ningpj/myVoronMods/README.md

# Voron_Mods

Various modifications created for my Voron printers.
