ningpj/myVoronMods/v0.2 Crossbow Cutter Depressor/README.md

# v0.2 Crossbow Cutter Depressor

## Description

CNC Crossbow toolhead filament cutters are awesome. For a bit of fun, I fitted one to my V0.2 so EMU can act as a convenient filament changer rather than a full multi‑material setup.

I originally planned a servo‑actuated arm, but since the bed magnet already lets the build plate lift when printing edge‑to‑edge parts, losing a few millimetres of front print area isn’t the end of the world IMO.

I’ve created and evaluated several mounting options that bolt to the front‑left 1515 extrusion. This evolved to MK II mid‑body and MK III to further minimise lost build space. Currently using MK III. 

With MK I I lost roughly 7 mm × 25 mm of usable area and masked this in my slicer using `0x0, 0x25, 7x25, 7x0, 0x0`.
MK II and MK III you only sacrifice 7mm x 14mm of space - `0x0, 0x14, 7x14, 7x0, 0x0`

Happy‑Hare cutting settings for MK II & MK III:
```
variable_cutting_axis           : "y"
variable_pin_loc_xy             : 4.7, 2
variable_pin_park_dist          : -2
variable_pin_loc_compressed_xy  : 4.7, 16.5
```

> [!NOTE]
> X needs to be at least 4.7 mm so the Crossbow arm doesn’t hit the 1515 extrusion during the cut maneuver and causing skipped steps.

V0 2 Crossbow Depressor MK I
V0 2 Crossbow Depressor MK II
V0 2 Crossbow Depressor MK III

## Change Log

* Published
