ningpj/myVoronMods/Mellow Fly-SHT36 v2 Orbiter 2.0 CAN Mount/README.md

# Prototype v2.4 Mellow Fly-SHT36 v2.0 Orbiter 2.0 CAN Board mount and umbilical strain relief.

## Description

*** Note *** this needs to be reworked for use with Voron 2.4 as the CNA umbilical gets caught in left rear Z idler :-(

Mellow Fly-SHT36 v2.0 Orbiter 2.0 CAN board mount and umbilical strain relief. 90-degree with back turn.

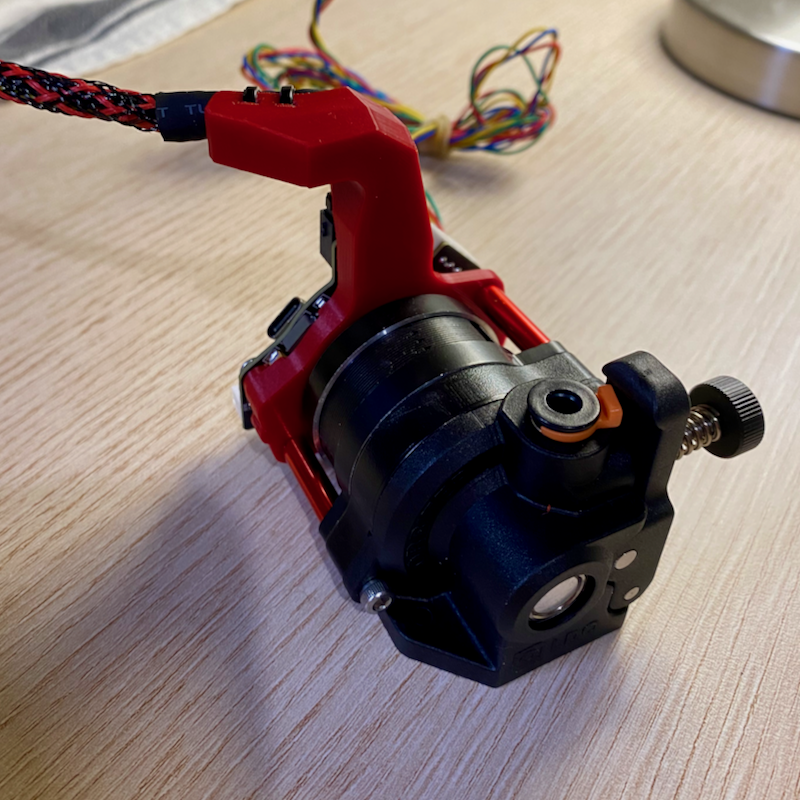
[picture p11: Mellow Fly-SHT36 v2 Orbiter 2.0 CAN Mount/images/Mellow_Fly-SHT36_v2_Orbiter_2_Mount_Front.png]

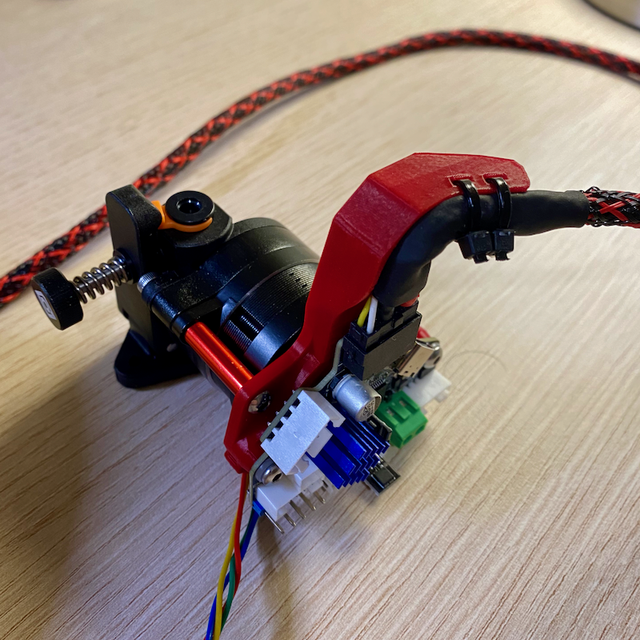
[picture p12: Mellow Fly-SHT36 v2 Orbiter 2.0 CAN Mount/images/Mellow_Fly-SHT36_v2_Orbiter_2_Mount_Back.png]


## Change Log

* Published
