ningpj/myVoronMods/v0.2 Dragon Burner Orbiter 2.0 Umbilical Toolheat Mount/README.md

# v0.2 Dragon Burner Orbitor 2.0 Umbilical Toolhead Mount

## Description

Remix of the VoronDesign v0.2 umbilical toolhead mount for Orbiter 2.0 and Dragon Burner hotend. The mount is offset slightly from stock and screws to the back of the x-carriage and standoffs attached to the Orbiter motor mount m3's.
Umbilical board and zip tie points relocated given offset layout and v0.2 x-carriage and Orbiter mounts.

Umbilical circuit board mounts using m3 into plastic (self-tap) on one side and through hole m3 to threaded standoff on other side.

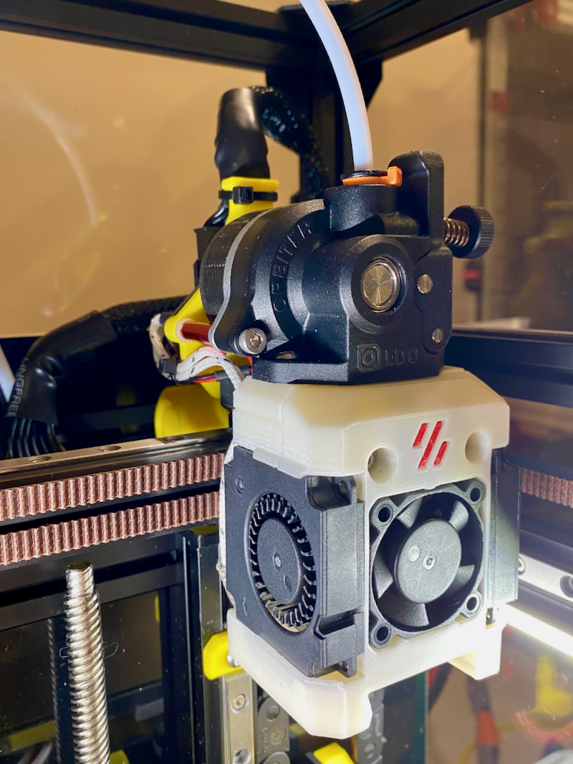
[picture p13: v0.2 Dragon Burner Orbiter 2.0 Umbilical Toolheat Mount/images/Orbiter_2.0_Umbilical_Dragon_Burner_Mount-front.png]
 <br><br>
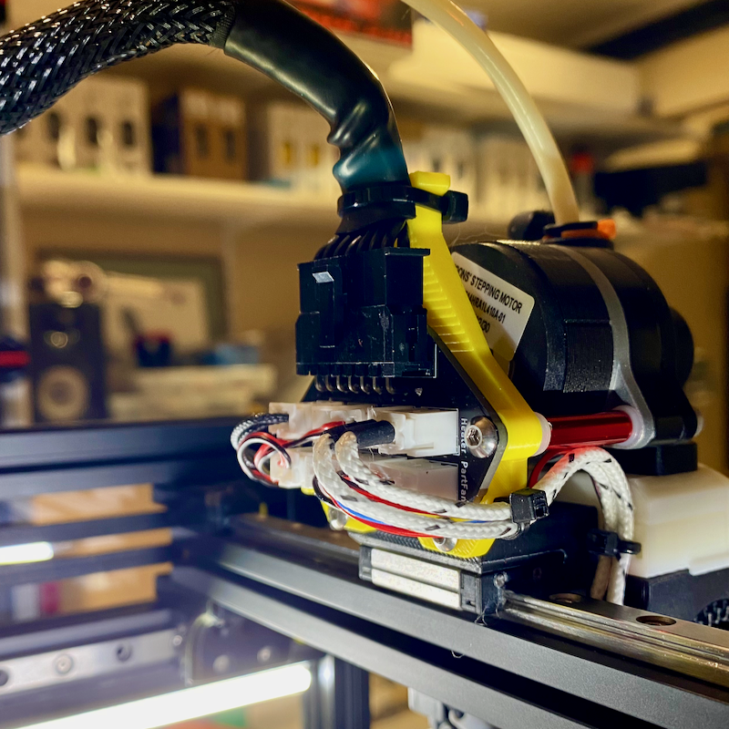
[picture p14: v0.2 Dragon Burner Orbiter 2.0 Umbilical Toolheat Mount/images/Orbiter_2.0_Umbilical_Dragon_Burner_Mount-back.png]


## Change Log

* Published
