ningpj/myVoronMods/v0.2 COB LED Press Fit Mount/README.md

# v0.2r1 COB LED Press Fit Mount

## Description

Quick remix (hack) using Tinkercad of @RichardM's excellent https://www.printables.com/model/172405-clip-in-led-mounts-for-voron-0-1515-extrusion 1515 LED mounts to change the profile to allow me to attach self-adhesive 24v COB LED light strips (natural white 4000k, 480 LEDS/metre).
I use COB lights for all my printers as they are simple, get the job done, PWM well, and have built in diffusers so don’t take up much space.  I PWM cap them at 60% power and run them at 40% when printing which is plenty bright enough.  In hindsight, 384 LEDS/metre would provide ample illumination for printer use. I have two short strips mounted under each Y rail.  Since I have no interest in servo mounted options at this stage for the v0.2 this keeps them well out of the way and means I dont have to faff around wiring up 5v nozzle sequin LEDs on the hotend as they throw sufficient light to see whats going on.  

@RicharM 1515 mounts are really elegant and are the best press fit channel mounts I have seen.  They use sets of 3, alternating interlocking fingers that snap into the 1515 channels and hold on super tight - all credit for the excellent design to https://www.printables.com/@RichardM.
Richard is also a member of the Voron Discord @whistlinric 

They do need to be printed vertically so will need to print these on a bigger printer than the v0.2.

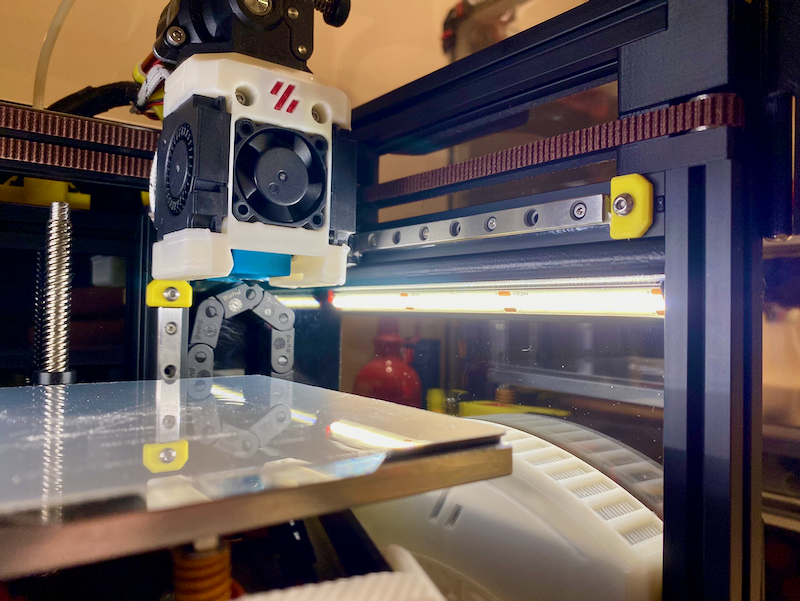
[picture p16: v0.2 COB LED Press Fit Mount/images/1515_COB_LED_Mount.png]


## Change Log

* Published
