ningpj/myVoronMods/v0.2 Stealth Rear Skirt with 2x Keystones/README.md

# v0.2 Stealth Skirts Rear Panel Keystones

## Description

Remixed and modified rear Stealth Skirts panel for v0.2 with dual keystone ports for RJ45 joiners for RPi Ethernet and Input Shaper ports.
Note this is for the standard v0.2 Stealth Skirts and "may" need updated when Maveric gets around to raisng the feet and incorporating v0.2r1 
integrated runout detector. 

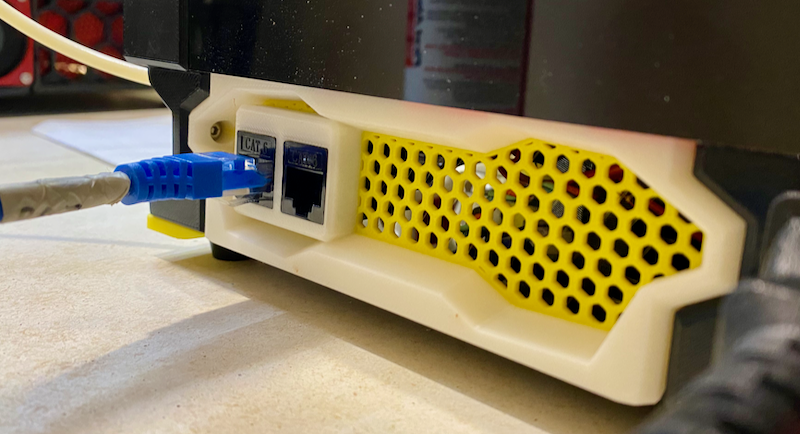
[picture p22: v0.2 Stealth Rear Skirt with 2x Keystones/images/Rear_Stealth_Skirt_with_2x_Keystones_1.png]

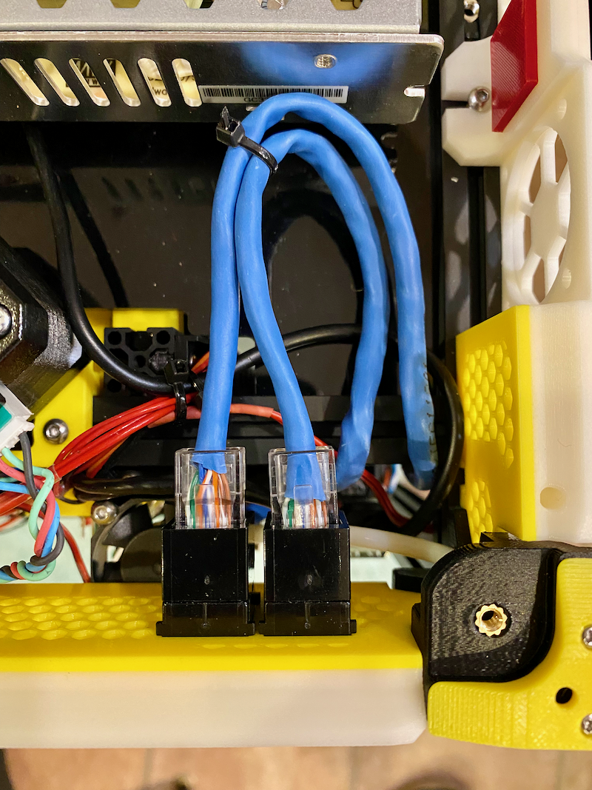
[picture p23: v0.2 Stealth Rear Skirt with 2x Keystones/images/Rear_Stealth_Skirt_with_2x_Keystones_2.png]

<br><br>
Unfortunately this symetrical orientation didnt allow enought room to clear the Z Stepper with RJ45 keystone joiner and plug/cable so needed to
change the layout :-(   
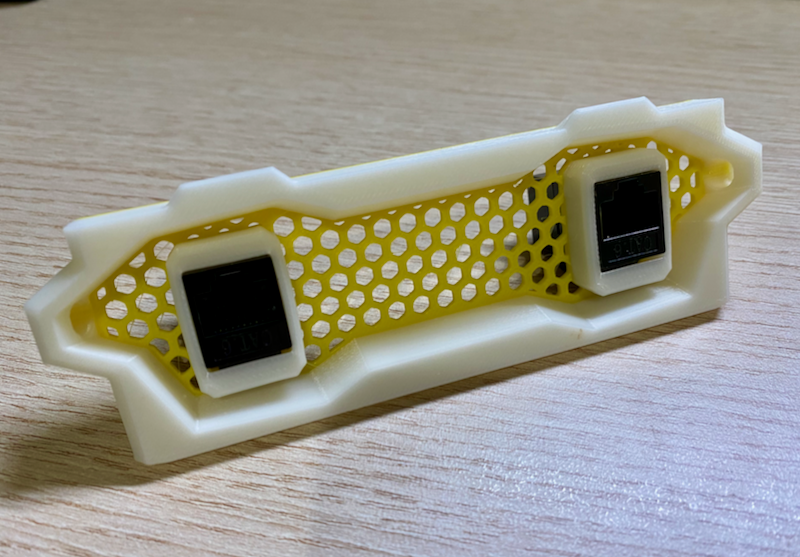
[picture p24: v0.2 Stealth Rear Skirt with 2x Keystones/images/Rear_Stealth_Skirt_with_2x_Keystones.png]


## Change Log

* Published
