ningpj/myVoronMods/Blobifier Modifications/images/v2.4_Extended_Static_Wipe_Rest.png

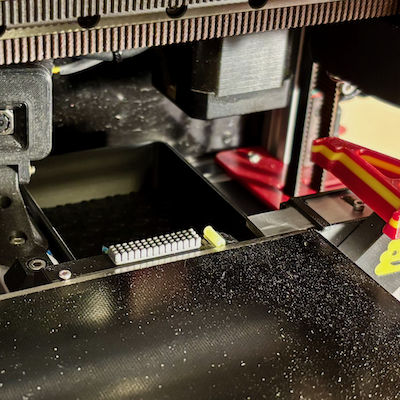
Blobifier Modifications/images/v2.4_Extended_Static_Wipe_Rest.png
