ningpj/myVoronMods/Blobifier Modifications/images/v2.4_Gantry_Wipe_Rest_MK_I.png

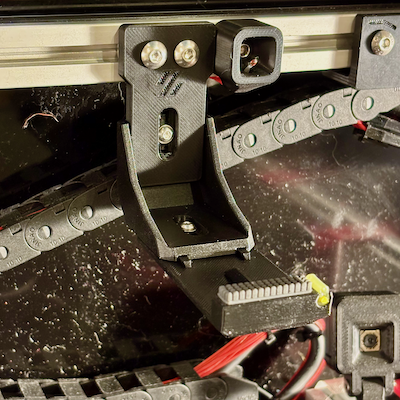
Blobifier Modifications/images/v2.4_Gantry_Wipe_Rest_MK_I.png
