ningpj/myVoronMods/Blobifier Modifications/images/v2.4_Gantry_Wipe_Rest_MK_I_Parked.png

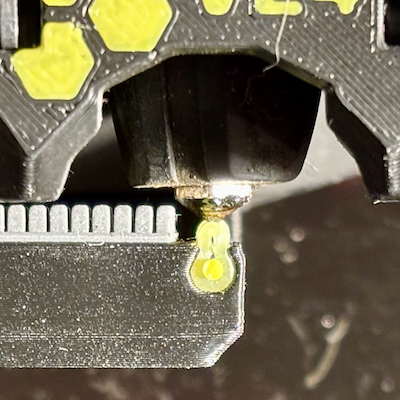
Blobifier Modifications/images/v2.4_Gantry_Wipe_Rest_MK_I_Parked.png
