ningpj/myVoronMods/Blobifier Modifications/images/Voron_v2.4_300mm_Blobifier_Dimensions.png

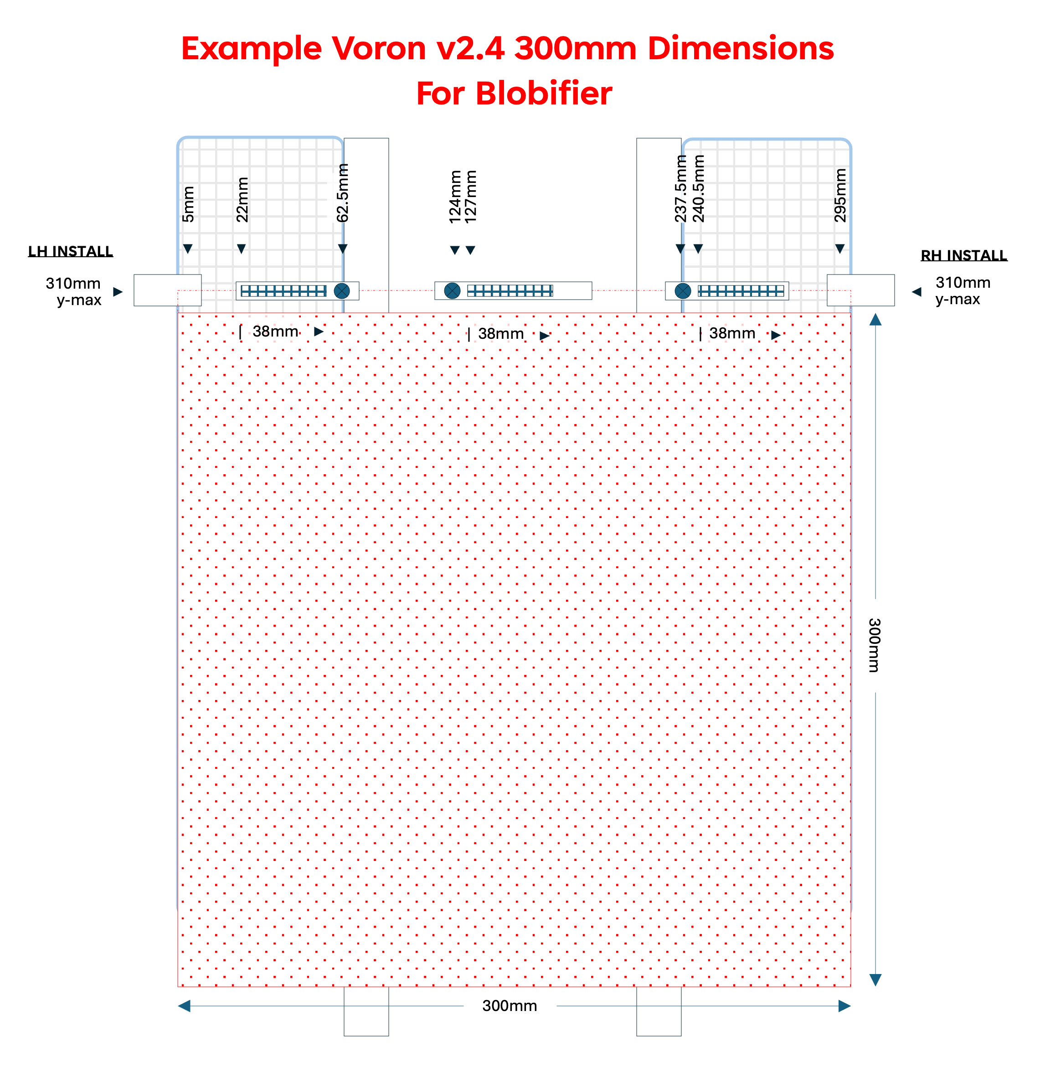
Blobifier Modifications/images/Voron_v2.4_300mm_Blobifier_Dimensions.png
