ningpj/myVoronMods/Blobifier Modifications/Adjustable Gantry Wiper - Mount.step

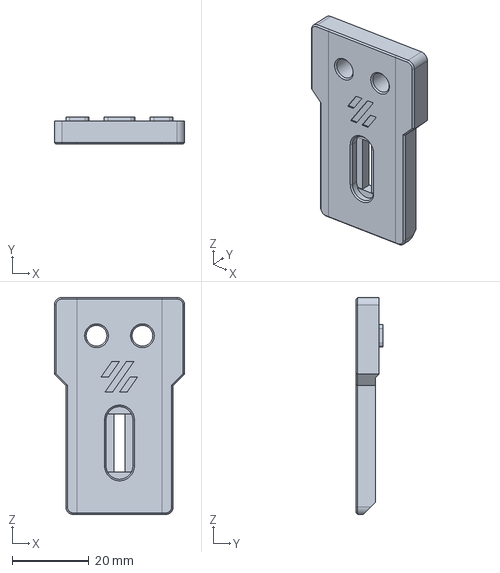
[picture p29: CAD file, 2025-07-21]
Blobifier Modifications/Adjustable Gantry Wiper - Mount.step
34.1 x 6.98 x 56.7 mm
