ningpj/myVoronMods/ERCF v2 Community Universal Servo Horn/Universal Servo Horn - M3 Hex.stl

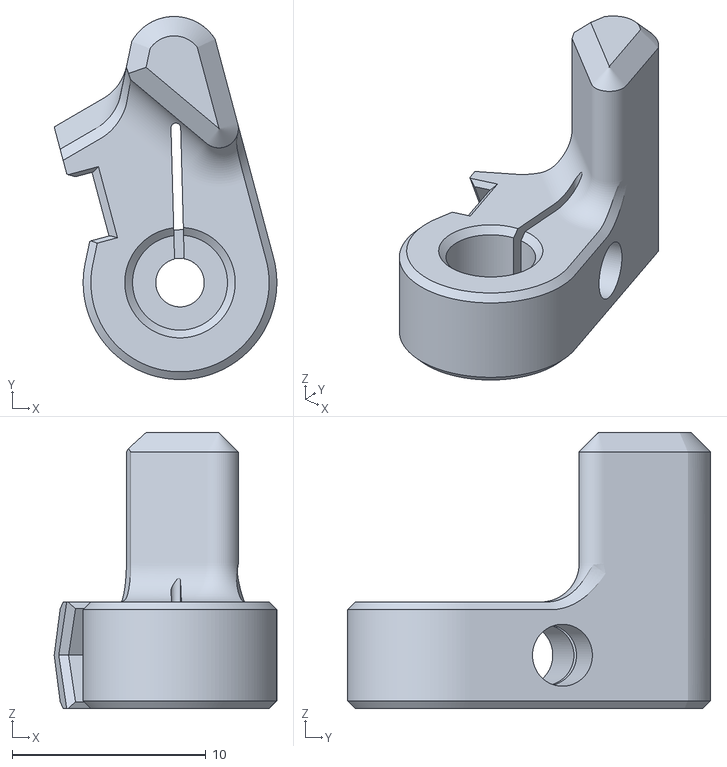
[picture p30: CAD file, 2024-08-23]
ERCF v2 Community Universal Servo Horn/Universal Servo Horn - M3 Hex.stl
11.5 x 18.7 x 14.2
