ningpj/myVoronMods/Mellow Fly-SHT36 v2 Orbiter 2.0 CAN Mount/Mellow BTT FLY-SHT-36 v2 Orbiter 2.0 CAN Mount v51.step

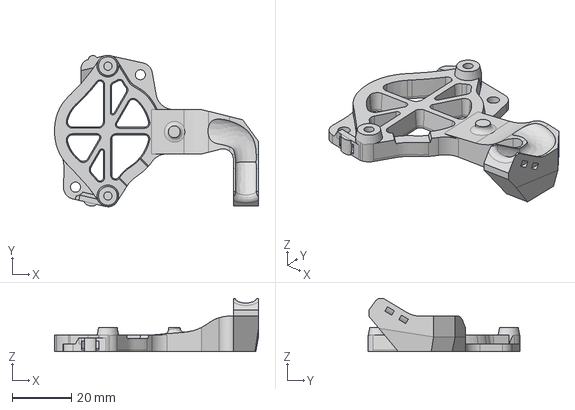
[picture p31: CAD file, 2023-07-01]
Mellow Fly-SHT36 v2 Orbiter 2.0 CAN Mount/Mellow BTT FLY-SHT-36 v2 Orbiter 2.0 CAN Mount v51.step
68.9 x 51.2 x 18.0 mm
