ningpj/myVoronMods/v0.2 ADXL Nozzle Mount/ADXL Nozzle Mount m3.stl

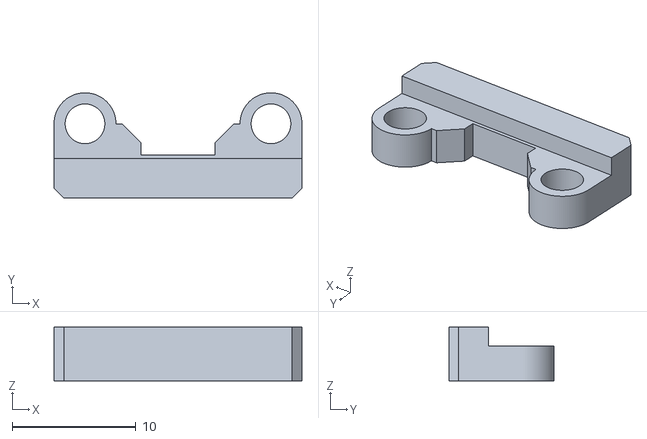
[picture p32: CAD file, 2023-06-18]
v0.2 ADXL Nozzle Mount/ADXL Nozzle Mount m3.stl
20.0 x 8.50 x 4.32
