ningpj/myVoronMods/v0.2 Aliexpress Clone Waggo 221-412 Kirigami mount/Aliexpress Clone Wago 221-412 3x2 Kirigami mount v4.step

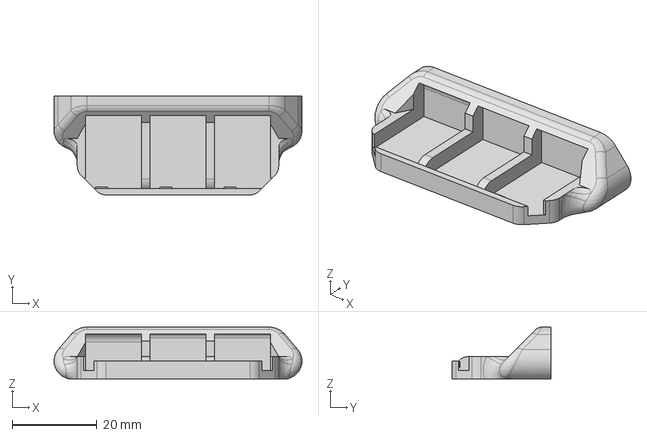
[picture p33: CAD file, 2023-06-18]
v0.2 Aliexpress Clone Waggo 221-412 Kirigami mount/Aliexpress Clone Wago 221-412 3x2 Kirigami mount v4.step
58.4 x 23.2 x 12.2 mm
