ningpj/myVoronMods/v0.2 COB LED Press Fit Mount/COB Light Remix - Funky Hango-Wluff.stl

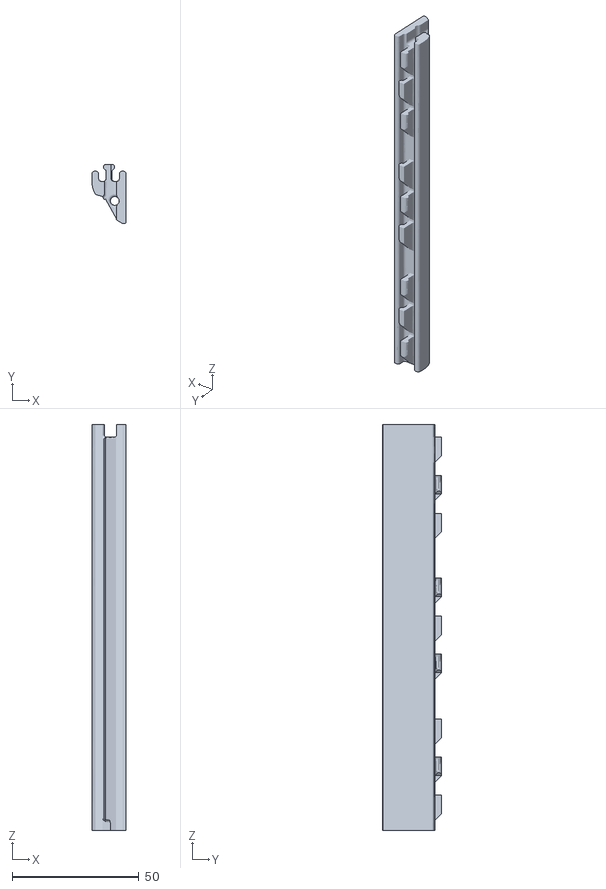
[picture p34: CAD file, 2023-06-18]
v0.2 COB LED Press Fit Mount/COB Light Remix - Funky Hango-Wluff.stl
13.5 x 23.4 x 160.0
