ningpj/myVoronMods/v0.2 Crossbow Cutter Depressor/V0.2 Crossbow Depressor MK III v4.step

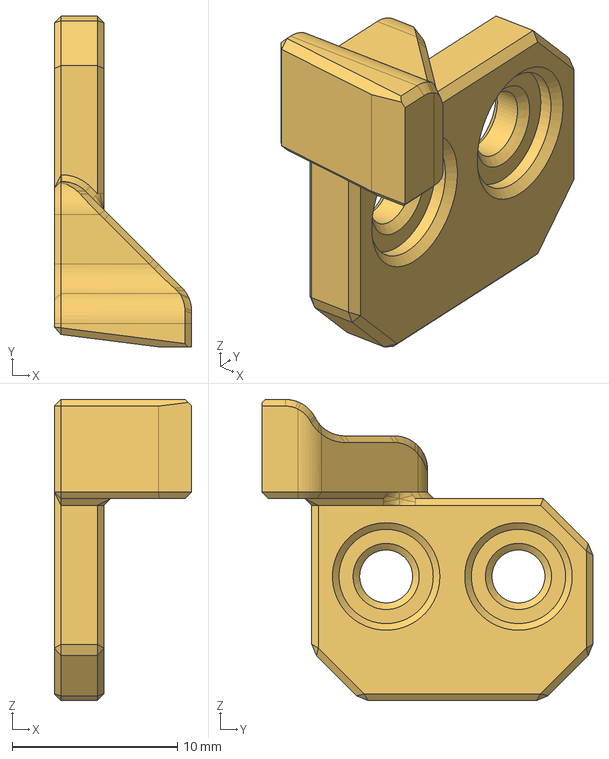
[picture p35: CAD file, 2026-05-24]
v0.2 Crossbow Cutter Depressor/V0.2 Crossbow Depressor MK III v4.step
8.30 x 20.0 x 18.2 mm
