ningpj/myVoronMods/v0.2 Dragon Burner Orbiter 2.0 Umbilical Toolheat Mount/v0.2 Dragon Burner Orbiter 2.0 Umbilical Toolhead Mount.stl

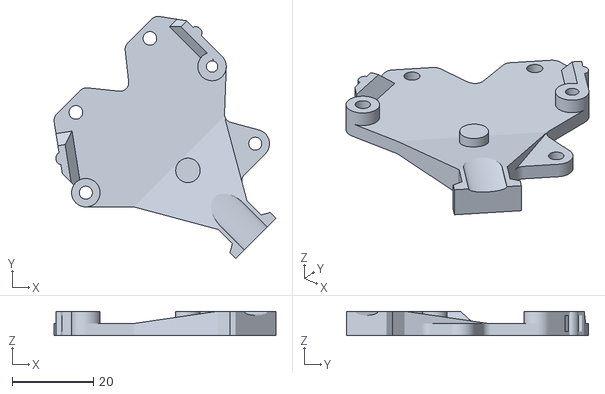
[picture p36: CAD file, 2023-06-20]
v0.2 Dragon Burner Orbiter 2.0 Umbilical Toolheat Mount/v0.2 Dragon Burner Orbiter 2.0 Umbilical Toolhead Mount.stl
54.5 x 59.5 x 6.00
