ningpj/myVoronMods/v0.2 Formbot Deck Chain Cap Cover/v0.2 Formbot Deck Chain Gap Cover.stl

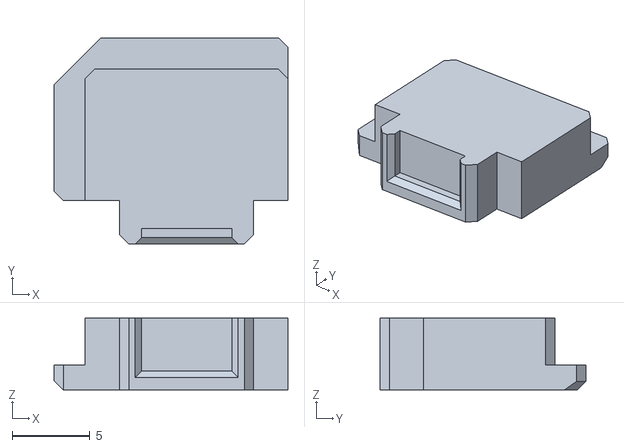
[picture p37: CAD file, 2023-06-20]
v0.2 Formbot Deck Chain Cap Cover/v0.2 Formbot Deck Chain Gap Cover.stl
15.0 x 13.2 x 4.60
