ningpj/myVoronMods/v0.2 Formbot Umbilical Panel Thermistor Shroud/V0.2 Formbot Umbilical Panel Thermistor Shroud v7.step

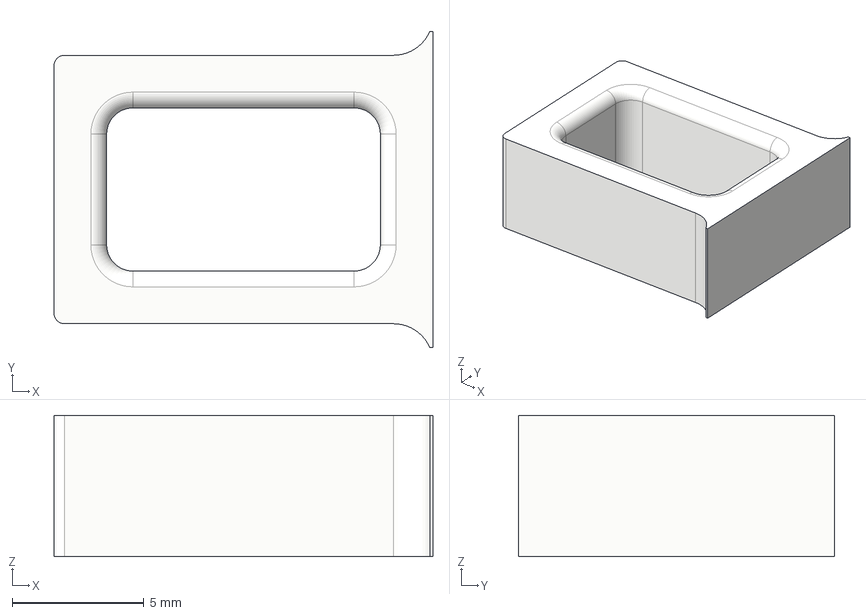
[picture p38: CAD file, 2023-06-18]
v0.2 Formbot Umbilical Panel Thermistor Shroud/V0.2 Formbot Umbilical Panel Thermistor Shroud v7.step
14.4 x 12.0 x 5.36 mm
