ningpj/myVoronMods/v0.2 Stealth Handle Top Hat, Side Panel Gap Fillers/Left Gap Filler.stl

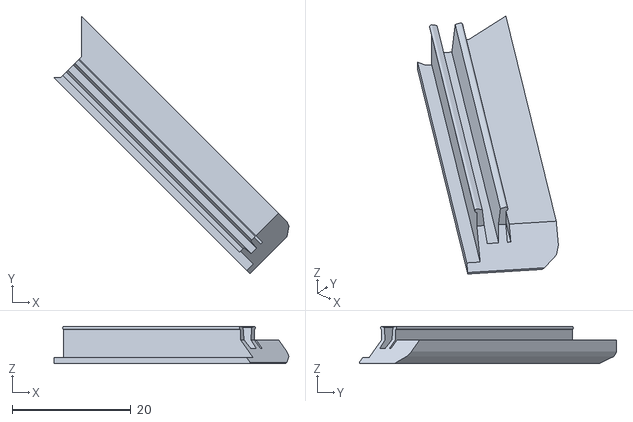
[picture p39: CAD file, 2023-06-18]
v0.2 Stealth Handle Top Hat, Side Panel Gap Fillers/Left Gap Filler.stl
39.6 x 43.4 x 6.25
