ningpj/myVoronMods/v0.2 Stealth Rear Skirt with 2x Keystones/V0.2 Rear Stealth Skirt with 2x Keystones v15.step

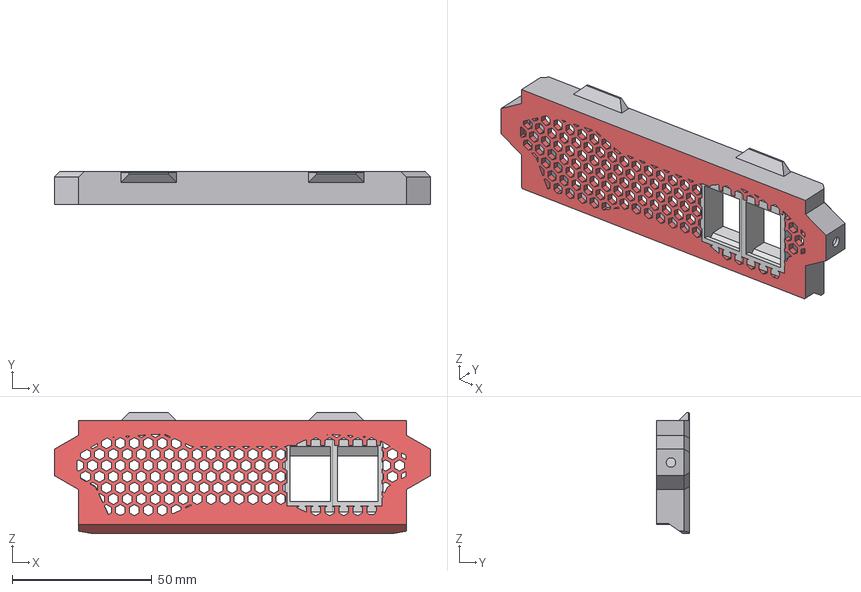
[picture p40: CAD file, 2023-06-25]
v0.2 Stealth Rear Skirt with 2x Keystones/V0.2 Rear Stealth Skirt with 2x Keystones v15.step
134.7 x 12.0 x 43.5 mm
Rear Skirt:1
Keystone
Keystone (1)
