ningpj/myVoronMods/v0.2 Sturdy PTFE & Umbilical Strain Relief/v0.2 Sturdy PTFE & Umbilical Strain Relief v10.step

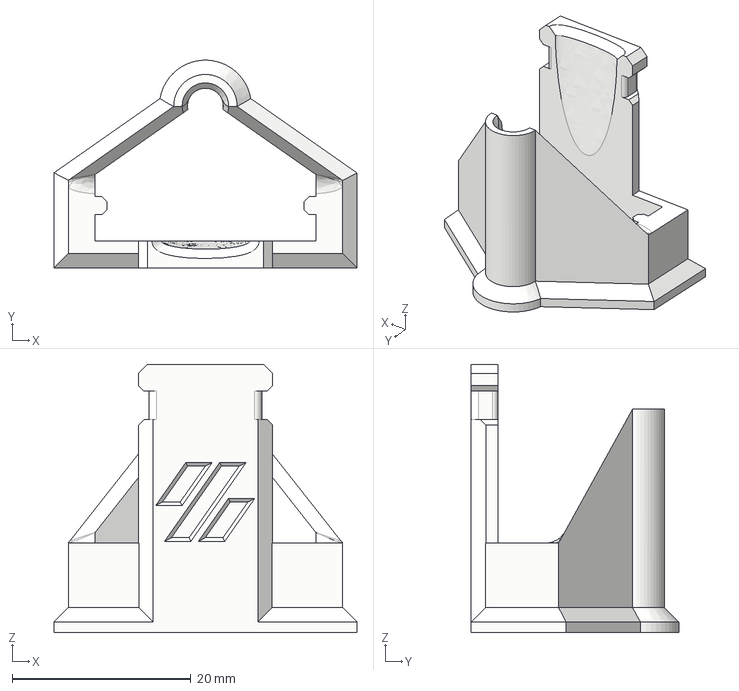
[picture p41: CAD file, 2023-06-18]
v0.2 Sturdy PTFE & Umbilical Strain Relief/v0.2 Sturdy PTFE & Umbilical Strain Relief v10.step
33.9 x 23.2 x 30.0 mm
