ningpj/myVoronMods/Blobifier Modifications/Adjustable Gantry Wiper - Bracket.step

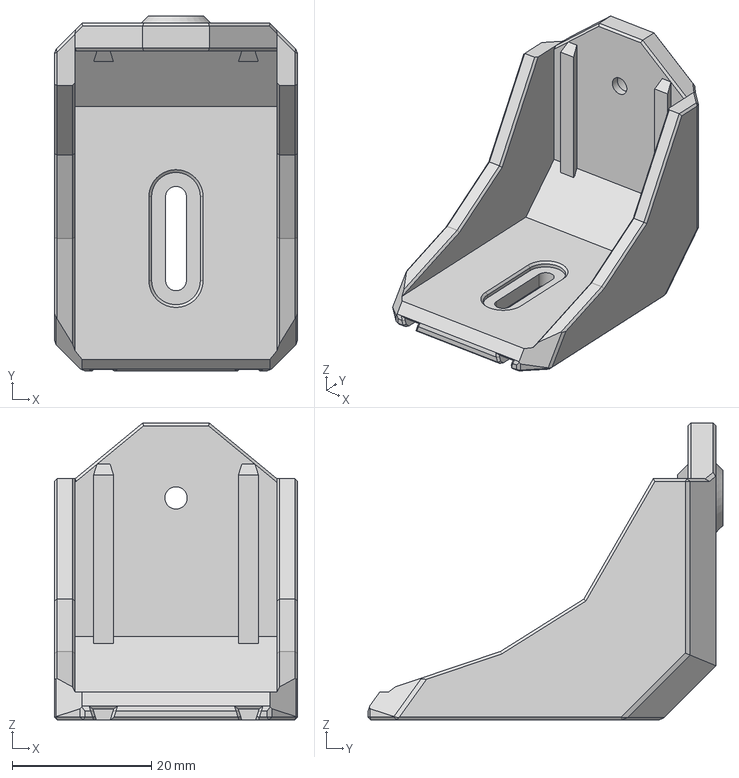
[picture p42: CAD file, 2025-07-21]
Blobifier Modifications/Adjustable Gantry Wiper - Bracket.step
35.0 x 51.0 x 42.7 mm
