ningpj/myVoronMods/ERCF v2 Community Universal Servo Horn/Universal Servo Horn - M3 Hex v14.step

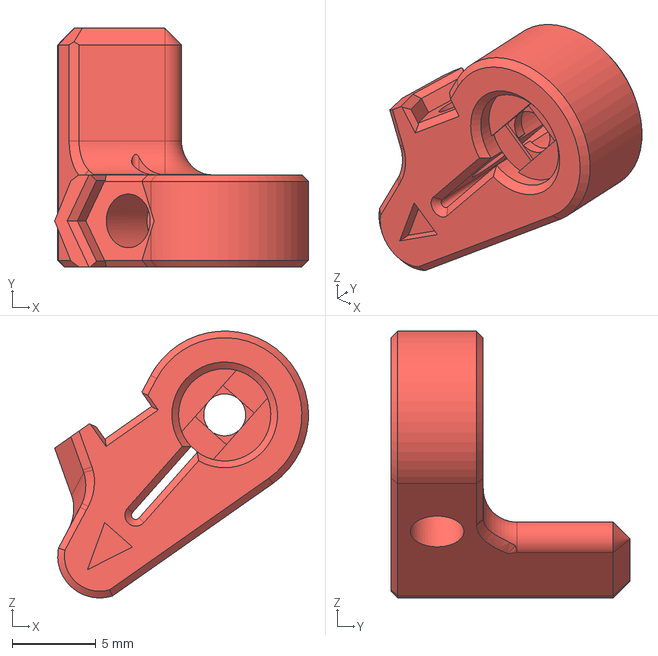
[picture p43: CAD file, 2024-08-23]
ERCF v2 Community Universal Servo Horn/Universal Servo Horn - M3 Hex v14.step
15.1 x 14.2 x 15.9 mm
