ningpj/myVoronMods/v0.2 Crossbow Cutter Depressor/V0.2 Crossbow Depressor MK II v2.step

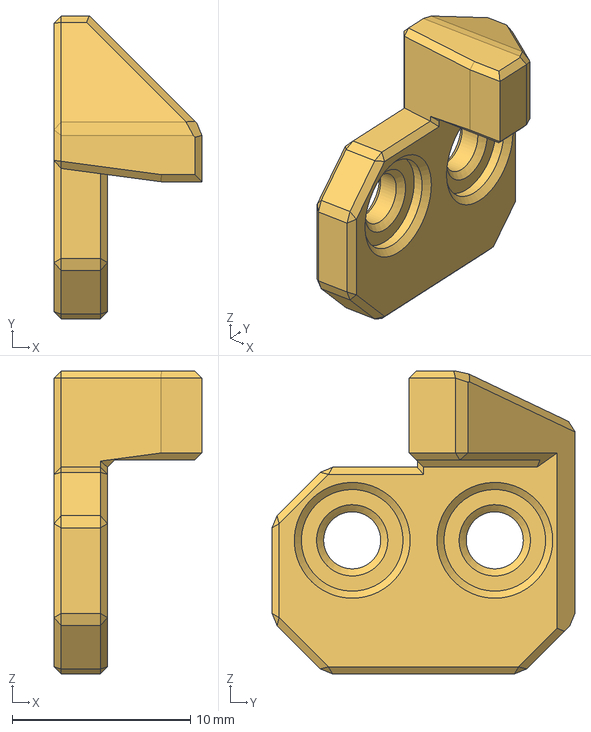
[picture p44: CAD file, 2026-05-22]
v0.2 Crossbow Cutter Depressor/V0.2 Crossbow Depressor MK II v2.step
8.30 x 17.0 x 17.0 mm
