ningpj/myVoronMods/v0.2 Dragon Burner Orbiter 2.0 Umbilical Toolheat Mount/v0.2 Dragon_Burner_Orbiter2.0 Umbilical Toolhead Mount v28.step

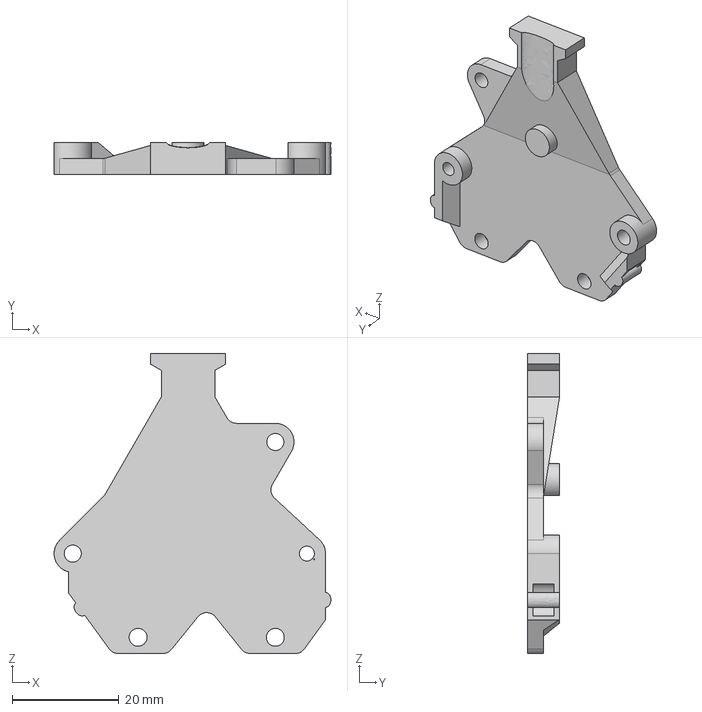
[picture p45: CAD file, 2023-06-18]
v0.2 Dragon Burner Orbiter 2.0 Umbilical Toolheat Mount/v0.2 Dragon_Burner_Orbiter2.0 Umbilical Toolhead Mount v28.step
51.8 x 6.00 x 56.2 mm
