ningpj/myVoronMods/v0.2 Formbot Umbilical Panel Thermistor Shroud/V0.2 4-way JST Fan Bus v7.step

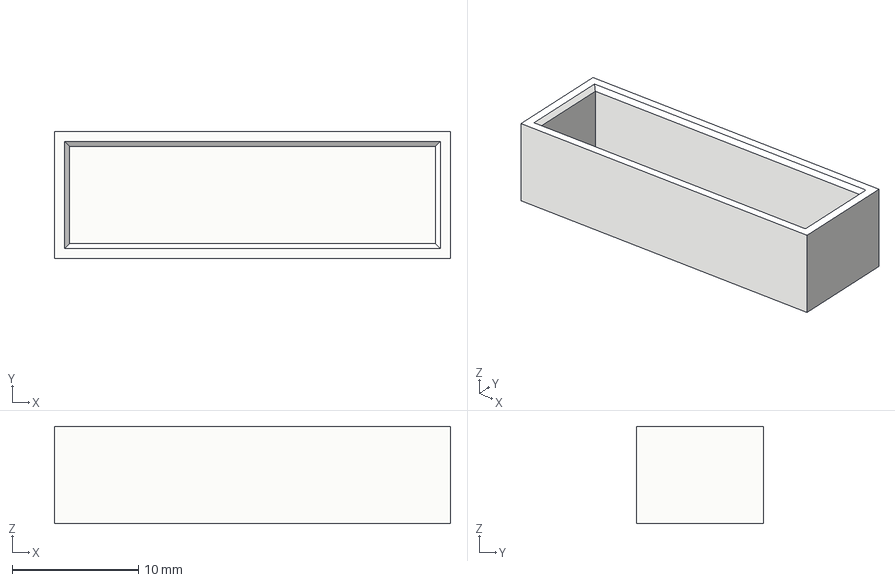
[picture p46: CAD file, 2023-06-18]
v0.2 Formbot Umbilical Panel Thermistor Shroud/V0.2 4-way JST Fan Bus v7.step
31.4 x 10.1 x 7.70 mm
