ningpj/myVoronMods/Blobifier Modifications/Adjustable Gantry Wiper - Wiper and rest.step

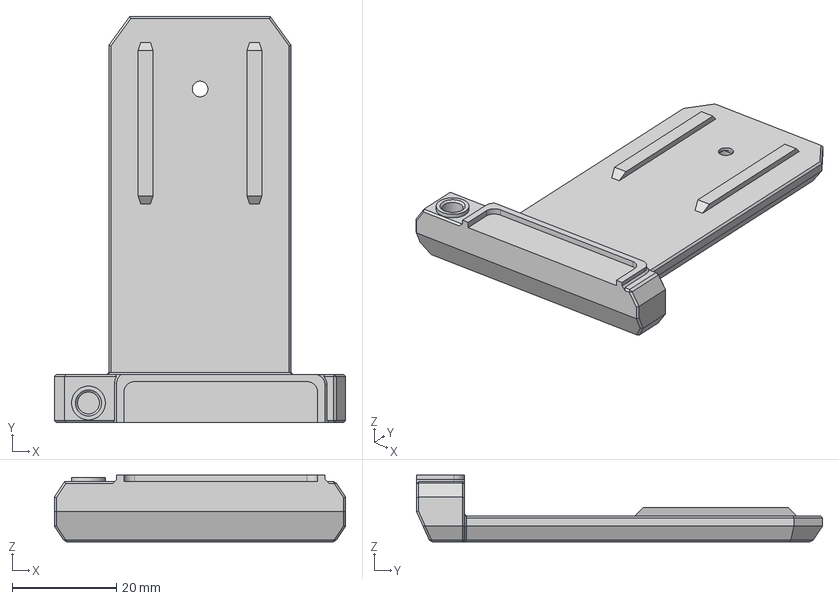
[picture p47: CAD file, 2025-07-21]
Blobifier Modifications/Adjustable Gantry Wiper - Wiper and rest.step
56.0 x 78.0 x 12.8 mm
