ningpj/myVoronMods/v0.2 Crossbow Cutter Depressor/V0.2 Crossbow Depressor MK I v5.step

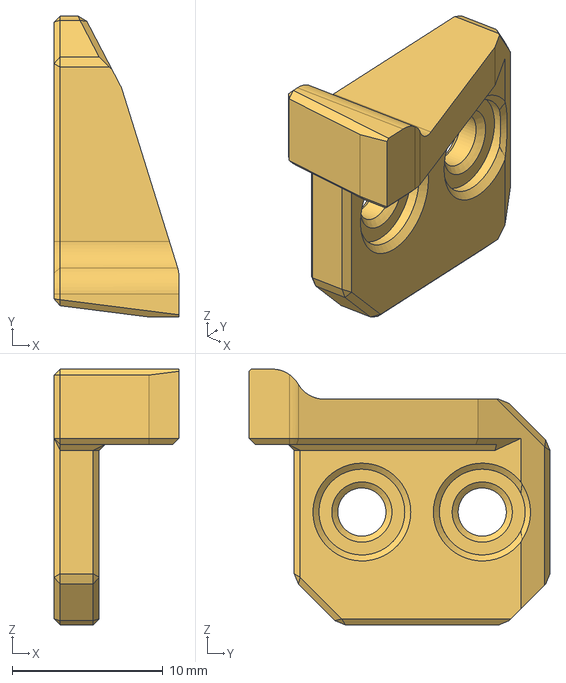
[picture p48: CAD file, 2026-05-22]
v0.2 Crossbow Cutter Depressor/V0.2 Crossbow Depressor MK I v5.step
8.30 x 20.0 x 17.0 mm
