ningpj/myVoronMods/v0.2 Stealth Handle Top Hat, Side Panel Gap Fillers/v2.0 Stealth Handle top hat, side panel gap fillers v15.step

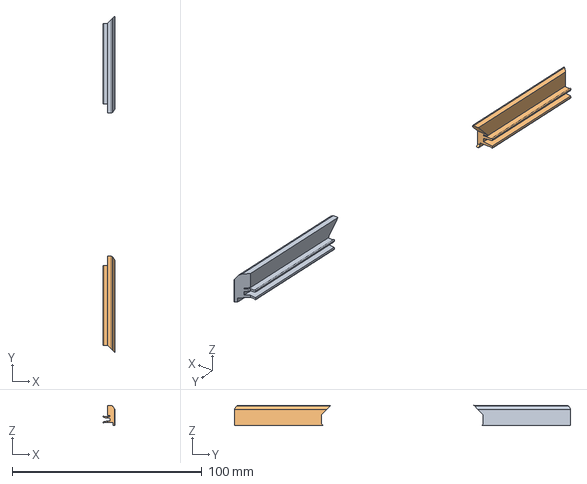
[picture p49: CAD file, 2023-06-18]
v0.2 Stealth Handle Top Hat, Side Panel Gap Fillers/v2.0 Stealth Handle top hat, side panel gap fillers v15.step
6.25 x 177.0 x 10.6 mm
