ningpj/myVoronMods/Blobifier Modifications/Adjustable Gantry & Static wipe & rests v32 - Mount.stl

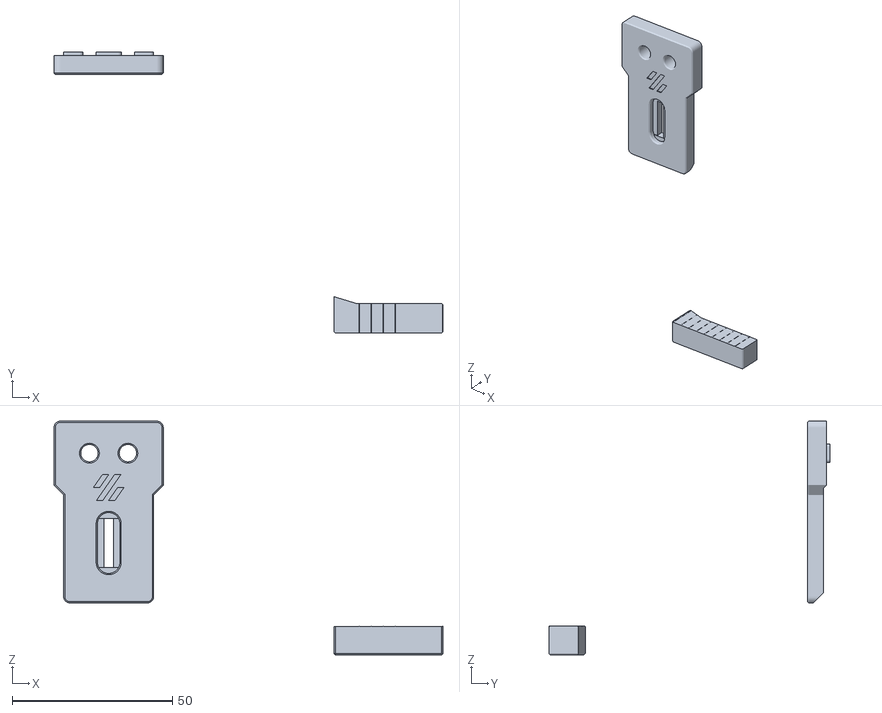
[picture p50: CAD file, 2025-03-07]
Blobifier Modifications/Adjustable Gantry & Static wipe & rests v32 - Mount.stl
121.3 x 87.6 x 72.9
