ningpj/myVoronMods/Blobifier Modifications/Adjustable Gantry Wipe Rest v15 - Mount.stl

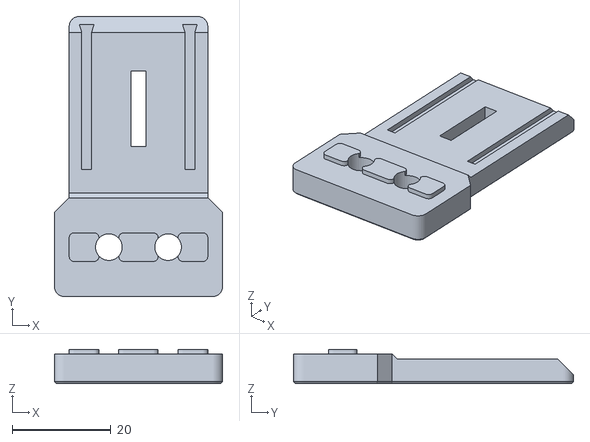
[picture p51: CAD file, 2025-01-22]
Blobifier Modifications/Adjustable Gantry Wipe Rest v15 - Mount.stl
34.1 x 56.7 x 6.98
