ningpj/myVoronMods/Blobifier Modifications/Adjustable Gantry Nozzle wipe & static wipe rest v33 - Static Rest.stl

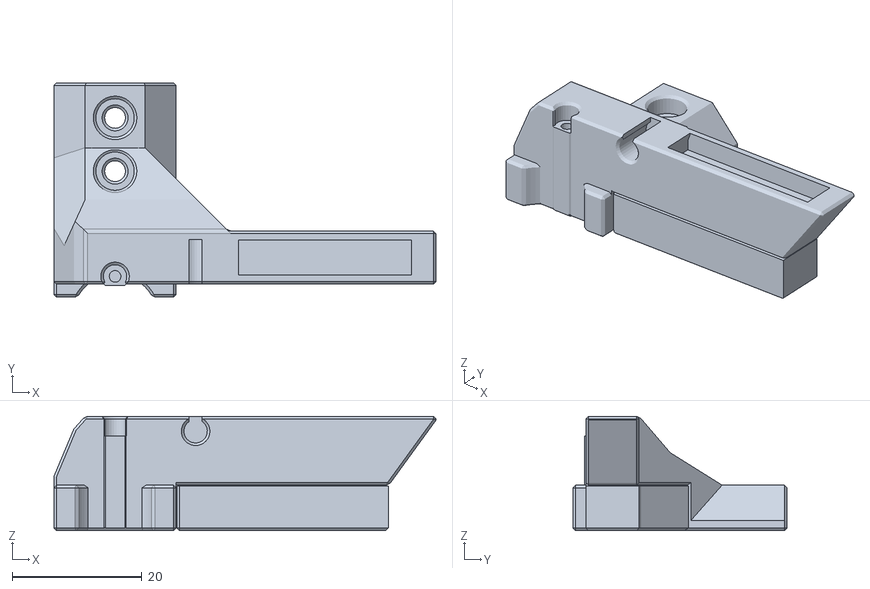
[picture p52: CAD file, 2025-01-13]
Blobifier Modifications/Adjustable Gantry Nozzle wipe & static wipe rest v33 - Static Rest.stl
58.8 x 33.0 x 17.6
