ningpj/myVoronMods/Blobifier Modifications/Adjustable Gantry Nozzle wipe & static wipe rest v30.step

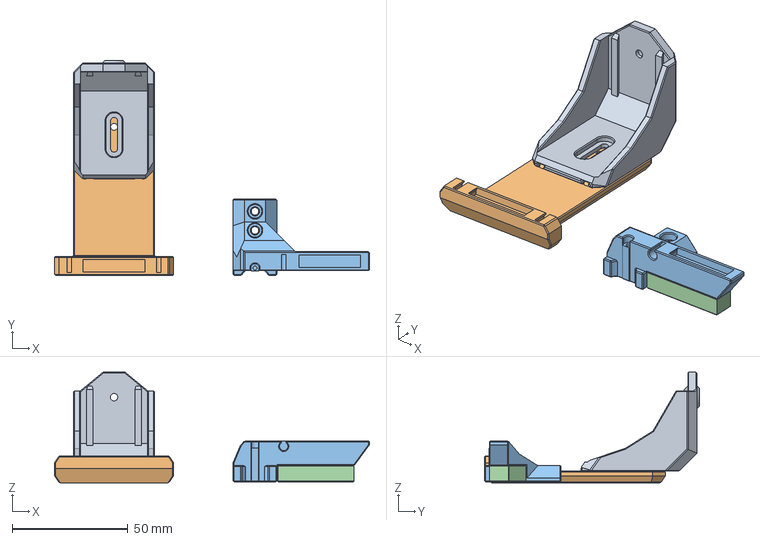
[picture p53: CAD file, 2025-01-13]
Blobifier Modifications/Adjustable Gantry Nozzle wipe & static wipe rest v30.step
135.9 x 92.6 x 47.7 mm
