ningpj/myVoronMods/Blobifier Modifications/Adjustable Gantry Nozzle wipe & static wipe rest v30 - Arm - Double Rest.stl

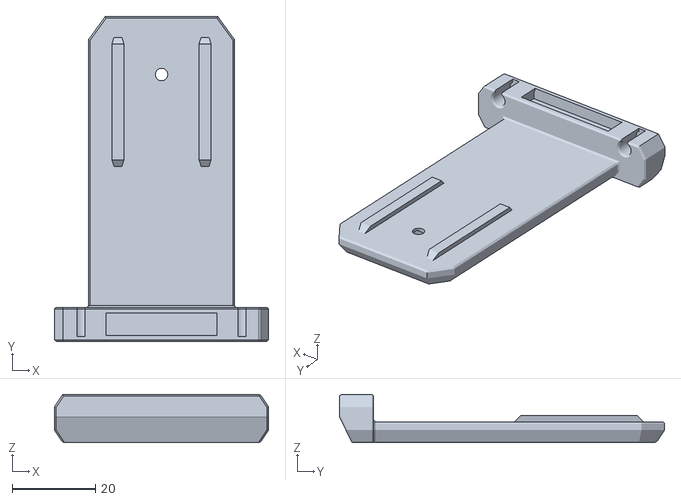
[picture p54: CAD file, 2025-01-13]
Blobifier Modifications/Adjustable Gantry Nozzle wipe & static wipe rest v30 - Arm - Double Rest.stl
51.4 x 78.0 x 11.6
