ningpj/myVoronMods/Blobifier Modifications/Blobifier Shaker Arm for Yavoth - LH Setup (Default).stl

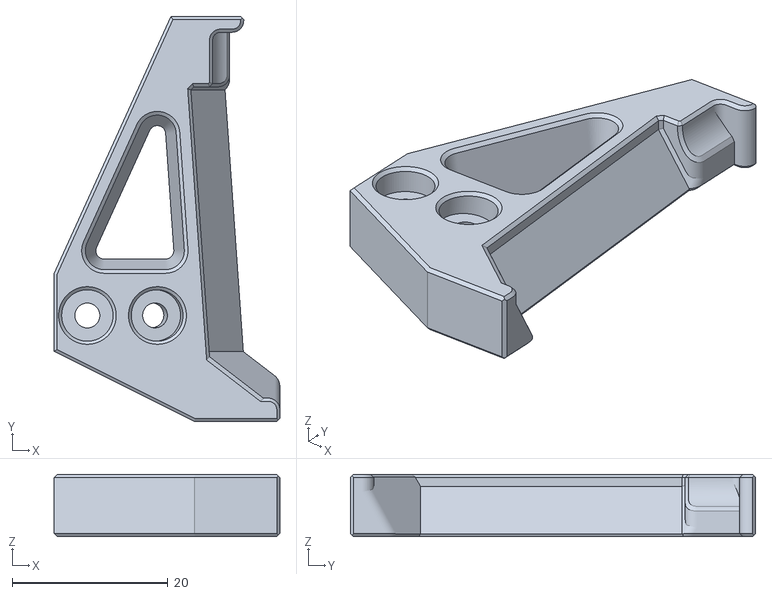
[picture p55: CAD file, 2025-01-13]
Blobifier Modifications/Blobifier Shaker Arm for Yavoth - LH Setup (Default).stl
29.0 x 52.0 x 8.00
