ningpj/myVoronMods/Blobifier Modifications/Adjustable Gantry Nozzle wipe & static wipe rest v23 - Arm - Double Rests.stl

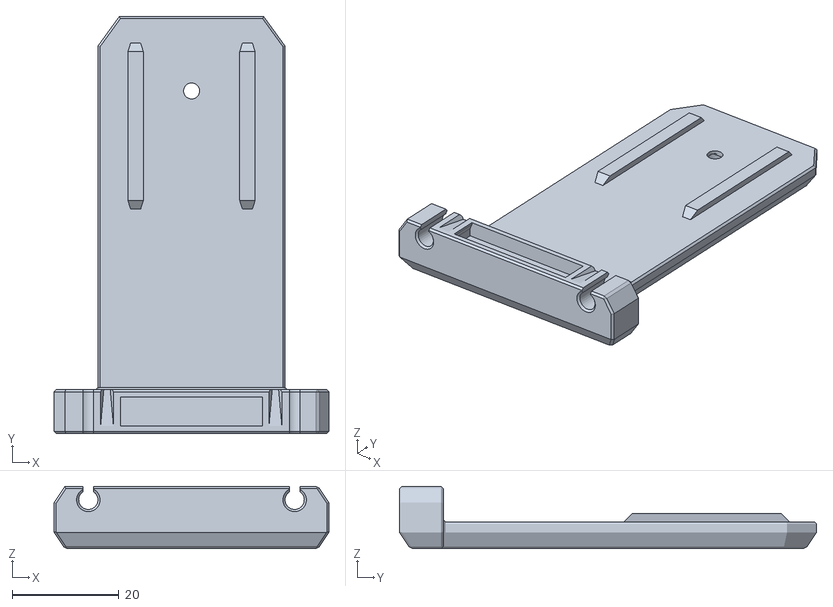
[picture p56: CAD file, 2025-01-07]
Blobifier Modifications/Adjustable Gantry Nozzle wipe & static wipe rest v23 - Arm - Double Rests.stl
51.4 x 78.0 x 11.6
