ningpj/myVoronMods/(list of files, cad)

Other CAD files:
v0.2 ADXL Nozzle Mount/ADXL Nozzle Mount v8.step
v0.2 Formbot Deck Chain Cap Cover/v0.2 Formbot Deck Chain Gap Cover v9.step
v0.2 Stealth Handle Top Hat, Side Panel Gap Fillers/Right Gap Filler.stl
v0.2 ADXL Nozzle Mount/ADXL Nozzle Mount m2.stl
v0.2 Formbot Umbilical Panel Thermistor Shroud/v0.2 Formbot Umbilical Thermistor Shroud.stl
Blobifier Modifications/Adjustable Gantry Wipe Rest v31 - Button Silicon Rest & A1 Wiper Arm - RH.stl
Blobifier Modifications/Adjustable Gantry Wipe Rest v32 - Bracket.stl.stl
Blobifier Modifications/Adjustable Gantry Wipe Rest v30 - Mount.stl.stl
Blobifier Modifications/Adjustable Gantry Wipe Rest v17 - Button Silicon Rest & A1 Wiper Arm LH.stl
Blobifier Modifications/Adjustable Gantry Wipe Rest v17 - Button Silicon Rest & A1 Wiper Arm RH.stl
Blobifier Modifications/Adjustable Gantry Wipe Rest v15 - Bracket.stl
Blobifier Modifications/Blobifier Shaker Arm for Yavoth - RH Setup.stl
Blobifier Modifications/Adjustable Gantry Nozzle wipe & static wipe rest v21 - Static Rest.stl
Blobifier Modifications/Adjustable Gantry Nozzle wipe & static wipe rest v21.step
Blobifier Modifications/Adjustable Gantry Nozzle wipe & static wipe rest v30 - Static Rest.stl
Blobifier Modifications/Archive/Adjustable Gantry Nozzle wipe & static wipe rest v21 - Static Rest.stl
Blobifier Modifications/Archive/Adjustable Gantry Nozzle wipe & static wipe rest v21.step
Blobifier Modifications/Archive/Adjustable Gantry Nozzle wipe & static wipe rest v30 - Static Rest.stl
Blobifier Modifications/Archive/Adjustable Gantry Wipe Rest v15 - Bracket.stl
Blobifier Modifications/Archive/Adjustable Gantry Wipe Rest v17 - Button Silicon Rest & A1 Wiper Arm LH.stl
Blobifier Modifications/Archive/Adjustable Gantry Wipe Rest v17 - Button Silicon Rest & A1 Wiper Arm RH.stl
Blobifier Modifications/Archive/Adjustable Gantry Wipe Rest v30 - Mount.stl.stl
Blobifier Modifications/Archive/Adjustable Gantry Wipe Rest v31 - Button Silicon Rest & A1 Wiper Arm - RH.stl
Blobifier Modifications/Archive/Adjustable Gantry Wipe Rest v32 - Bracket.stl.stl
Mellow Fly-SHT36 v2 Orbiter 2.0 CAN Mount/Mellow BTT FLY-SHT-36 v2 Orbiter 2.0 CAN Mount v51.stl
v0.2 ADXL Nozzle Mount/ADXL Nozzle Mount v8.f3d
v0.2 Aliexpress Clone Waggo 221-412 Kirigami mount/Aliexpress Clone Wago 221-412 3x2 Kirigami mount v4.f3d
v0.2 Aliexpress Clone Waggo 221-412 Kirigami mount/Aliexpress Clone Wago 221-412 3x2 Kirigami mount v4.stl
v0.2 Formbot Deck Chain Cap Cover/v0.2 Formbot Deck Chain Gap Cover v9.f3d
v0.2 Formbot Umbilical Panel Thermistor Shroud/V0.2 Formbot Umbilical Panel Thermistor & 4-way Fan Bus v7.f3d
v0.2 Formbot Umbilical Panel Thermistor Shroud/v0.2 4-way JST Fan Bus v7.stl
v0.2 Stealth Handle Top Hat, Side Panel Gap Fillers/v2.0 Stealth Handle Top Hat, Side Panel Gap Fillers v15.f3z
v0.2 Stealth Rear Skirt with 2x Keystones/V0.2 Rear Stealth Skirt with 2x Keystones v15.stl
v0.2 Sturdy PTFE & Umbilical Strain Relief/v0.2 Sturdy PTFE & Umbilical Strain Relief v10.f3d
v0.2 Sturdy PTFE & Umbilical Strain Relief/v0.2 Sturdy PTFE & Umbilical Strain Relief v10.stl
