ningpj/myVoronMods/(commit log)

2023-06-18 v0.2 modifications
    [4-way Fan Connector box.stl, ADXL Nozzle Mount M2.stl, ADXL Nozzle Mount m3.stl, ADXL Nozzle Mount v8.f3d, ADXL Nozzle Mount v8.step, Aliexpress Clone Wago 221-412 3x2 Kirigami mount v4.f3d, Aliexpress Clone Wago 221-412 3x2 Kirigami mount v4.step, Aliexpress Clone Wago 221-412 3x2 Kirigami mount v4.stl]
2023-06-18 Fix orientation
    [Left Gap Filler.stl, Right Gap Filler.stl]
2023-06-20 Correct orientation
    [v0.2 Dragon Burner Orbiter 2.0 Umbilical Toolhead Mount.stl]
2023-06-24 Stealth Skirts rear panel with 2x keystones
    [V0.2 Rear Stealth Skirt with 2x Keystones v10.step, V0.2 Rear Stealth Skirt with 2x Keystones v10.stl]
2023-06-24 Move Keystones
    Not enough room for RJ45 keystone joiner and plug to clear Z Stepper. Keystones moved to left
    [V0.2 Rear Stealth Skirt with 2x Keystones v12.step, V0.2 Rear Stealth Skirt with 2x Keystones v12.stl]
2023-06-25 Move keystones to left, not enough room to clear Z stepper
    [V0.2 Rear Stealth Skirt with 2x Keystones v15.step, V0.2 Rear Stealth Skirt with 2x Keystones v15.stl]
2023-07-01 Add files via upload
    New CAN mount and strain relief
    [Mellow BTT FLY-SHT-36 v2 Orbiter 2.0 CAN Mount v51.step, Mellow BTT FLY-SHT-36 v2 Orbiter 2.0 CAN Mount v51.stl]
2024-08-27 Add CAD step
    [Universal Servo Horn - M3 Hex v14.step]
2025-01-06 Add files via upload
    Add Voron 2.4 Gantry and Static Wipe Rest components
    [Adjustable Gantry Nozzle wipe & static wipe rest v21 - Arm.stl, Adjustable Gantry Nozzle wipe & static wipe rest v21 - Bracket.stl, Adjustable Gantry Nozzle wipe & static wipe rest v21 - Mount.stl, Adjustable Gantry Nozzle wipe & static wipe rest v21 - Static Rest.stl, Adjustable Gantry Nozzle wipe & static wipe rest v21.step]
2025-01-06 Add files via upload
    Fix orientation
    [Adjustable Gantry Nozzle wipe & static wipe rest v21 - Mount.stl]
2025-01-07 Add files via upload
    Fix heatset depth
    [Adjustable Gantry Nozzle wipe & static wipe rest v23 - Arm - Double Rests.stl]
2025-01-07 Renamed repo
    [Adjustable Gantry Nozzle wipe & static wipe rest v21 - Bracket.stl, Adjustable Gantry Nozzle wipe & static wipe rest v21 - Mount.stl, Adjustable Gantry Nozzle wipe & static wipe rest v21 - Static Rest.stl, Adjustable Gantry Nozzle wipe & static wipe rest v21.step, Adjustable Gantry Nozzle wipe & static wipe rest v23 - Arm - Double Rests.stl, mmu_gantry_park_wipe.cfg, mmu_user_blobifier.cfg]
2025-01-13 Updates
    Move silicon rest for static wiper to left, lift and shorten wiper arm to allow more space for blobs to pile up. Change silicon tube mounting to mount from back and increase front edge chamfer of arm to cope better when/if contact with the build plate due to sag prior to QGL
    [Adjustable Gantry Nozzle wipe & static wipe rest v30 - Arm - Double Rests.stl, Adjustable Gantry Nozzle wipe & static wipe rest v30 - Static Rest.stl, Blobifier Shaker Arm for Yavoth - LH Setup (Default).stl, Blobifier Shaker Arm for Yavoth - RH Setup.stl]
2025-01-13 Include updated step
    [Adjustable Gantry Nozzle wipe & static wipe rest v31.step]
2025-01-13 Move files to archive
    [Adjustable Gantry Nozzle wipe & static wipe rest v21 - Static Rest.stl, Adjustable Gantry Nozzle wipe & static wipe rest v21.step, Adjustable Gantry Nozzle wipe & static wipe rest v23 - Arm - Double Rests.stl, Adjustable Gantry Nozzle wipe & static wipe rest v30 - Arm - Double Rest.stl]
2025-01-13 Rename step with correct version
    [Adjustable Gantry Nozzle wipe & static wipe rest v30.step]
2025-01-13 Minor refinement to sharpen static wiper end
    [Adjustable Gantry Nozzle wipe & static wipe rest v33 - Static Rest.stl, Adjustable Gantry Nozzle wipe & static wipe rest v33.step]
2025-01-13 ARchive old files
    [Adjustable Gantry Nozzle wipe & static wipe rest v30 - Static Rest.stl, Adjustable Gantry Nozzle wipe & static wipe rest v30.step]
2025-01-15 Voron v2.4 300mm Example Dimensions
2025-01-16 Testing 250c nozzle rest options - button style
    [Adjustable Gantry wipe v7 - 205c Silicon Button & A1 Wiper.stl]
2025-01-16 Switch to PTFE sleeve
    Hold rest, insulate, & make height adjustable
    [Adjustable Gantry wipe v9 - 205c Silicon Button & A1 Wiper.stl]
2025-01-17 PTFE tweaks
    [Adjustable Gantry Wipe & Rest v13 - 250c Silicon Button Rest & A1 Wiper.stl]
2025-01-18 Archive older variations
    [Adjustable Gantry Nozzle wipe & static wipe rest v30 - Arm - Double Rest.stl, Adjustable Gantry Nozzle wipe & static wipe rest v33 - Static Rest.stl]
2025-01-22 Alpha version of blobifier macros for LH & RH configurations
    Work in progress. More user parameter validation needed, testing of LH and RH motions e2e with different wipe and rest options, etc
    [mmu_user_bloblifer.cfg]
2025-01-22 Fix stl names
    [Blobifier Shaker Arm for Yavoth - LH Setup (Default).stl, Blobifier Shaker Arm for Yavoth - RH Setup.stl]
2025-01-22 Fix orientation for printing
    [Adjustable Gantry Wipe Rest v15 - Mount.stl]
2025-01-22 Add LH version
    [Adjustable Gantry Wipe Rest v17 - Button Silicon Rest & A1 Wiper Arm LH.stl]
2025-01-22 add LH stl for arm & rename files
    [Adjustable Gantry Wipe Rest v17 - Button Silicon Rest & A1 Wiper Arm LH Setup (Default).stl, Adjustable Gantry Wipe Rest v17 - Button Silicon Rest & A1 Wiper Arm RH Setup.stl]
2025-01-22 add hacky _BLOBIFIER_TEST_CONFIG macro
    Dynamically change blobifier config variables while testing e.g. _BLOBIFIER_TEST_CONFIG VARIABLE="purge_x" VALUE="295"
    [mmu_user_bloblifer.cfg]
2025-01-24 Beta
    Still has some testing code and macros
    [bloblifer2.cfg]
2025-01-24 Delete Blobifier Modifications/mmu_user_bloblifer.cfg
    Replaced with blobifier2.cfg macros
    [mmu_user_bloblifer.cfg]
2025-01-24 Beta - remove debug M118's
    [bloblifer2.cfg]
2025-01-24 Formatting and comments
    [bloblifer2.cfg]
2025-01-25 Gantry park_x fix
    Not parking on reset post wipe
    [bloblifer2.cfg]
2025-01-25 Minor updates to console messages
    [bloblifer2.cfg]
2025-01-25 Update comments and bucket full message
    [bloblifer2.cfg]
2025-01-27 klicky probe check
    add safe wrapper macros for blobifier and blobifier_park for users wanting blobifier to check if klicky is unexpectedly attached to bypassing blobbing and avoid possible gantry / probe collisions
    [bloblifer2.cfg]
2025-01-27 Update instructions
    [bloblifer2.cfg]
2025-01-28 Update comments
    [bloblifer2.cfg]
2025-01-28 added combo zig zag/swipe wipe option
    [bloblifer2.cfg]
2025-01-29 use map|float for validating setting lists
    Better error handling
    [bloblifer2.cfg]
2025-01-29 RH & LH stl options
    [Adjustable Gantry Wipe Rest v17 - Button Silicon Rest & A1 Wiper Arm LH.stl, Adjustable Gantry Wipe Rest v17 - Button Silicon Rest & A1 Wiper Arm RH.stl]
2025-01-29 Archive stls
    [Adjustable Gantry Wipe Rest v17 - Button Silicon Rest & A1 Wiper Arm.stl]
2025-01-29 Minor comment edits
    [bloblifer2.cfg]
2025-01-29 Change handling of accel settings
    set to -1 to leave unchanged, set to 0 to override to current max printer_accels or to specific value to use.
    warning if value > max printer_accels
    [bloblifer2.cfg]
2025-01-29 Update bloblifer2.cfg
    change slicer exclusion zone message
    [bloblifer2.cfg]
2025-01-29 Split out test macros from main file
    [blobifier2_test_macros.cfg, bloblifer2.cfg]
2025-02-02 HH conditional extruder sync
    [bloblifer2.cfg]
2025-02-03 Refine gear sync test
    map to in, current sync status always seems to be blank rather than boolean and need to look into this further
    [bloblifer2.cfg]
2025-02-03 Fix & lower wing chamfer to cover 2020
    [Adjustable Gantry Wipe Rest v30 - Mount.stl.stl]
2025-02-03 Archive files
    [Adjustable Gantry Wipe Rest v15 - Mount.stl]
2025-02-03 Reorient for printing
    Grr, fix and lower 2020 wings on mount AND remember to orient for printing <sigh>
    [Adjustable Gantry Wipe Rest v30 - Mount.stl.stl]
2025-02-04 refactor restore_z & add wiper chaining
    move restore_z to macro always restore most current position. Reset restore_z afterwards (-1)
    add logic to skip full static wiper sequence if < chain_wipers_after_z threshold. single swipe to end of wiper or reset before gantry wiper/rest
    [bloblifer2.cfg]
2025-02-04 uncomment x loc validation bypass while testing RH config
    [bloblifer2.cfg]
2025-02-04 switch to mmu_pause
    call mmu_pause, not pause directly
    [bloblifer2.cfg]
2025-02-15 updates needing testing
    [bloblifer2.cfg]
2025-03-07 Final revisions
    [Adjustable Gantry & Static wipe & rests v32 - Mount.stl, Adjustable Gantry Wipe Rest v15 - Bracket.stl, Adjustable Gantry Wipe Rest v17 - Button Silicon Rest & A1 Wiper Arm LH.stl, Adjustable Gantry Wipe Rest v17 - Button Silicon Rest & A1 Wiper Arm RH.stl, Adjustable Gantry Wipe Rest v30 - Mount.stl.stl, Adjustable Gantry Wipe Rest v31 - Button Silicon Rest & A1 Wiper Arm - LH.stl, Adjustable Ga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]
2025-03-07 Final tweaks
    [Adjustable Gantry & Static wipe & rests v32 - Mount.stl, Adjustable Gantry Wipe Rest v31 - Button Silicon Rest & A1 Wiper Arm - RH.stl, Adjustable Gantry Wipe Rest v32 - Bracket.stl.stl]
2025-07-12 Create v0.2 BTT Pi TFT 4.3 Mount & Front Stealth Skirt Mount
2025-07-21 Freshen wiper and rest files
    [Adjustable Gantry & Static wipe & rests v32 - Mount.stl, Adjustable Gantry Wipe Rest v31 - Button Silicon Rest & A1 Wiper Arm - RH.stl, Adjustable Gantry Wipe Rest v32 - Bracket.stl.stl, Blobifier Shaker Arm for Yavoth - LH Setup (Default).stl]
2026-05-22 Depressor options - MK II current & in use
    [V0.2 Crossbow Depressor MK I v5.step, V0.2 Crossbow Depressor MK II v2.step]
2026-05-22 Remove champher on edge to maximise contact area
    [V0.2 Crossbow Depressor MK II v2.step]
2026-05-24 Update README with multiple mounting options for cutter
2026-05-24 Add additional option based on MK I
    [V0.2 Crossbow Depressor MK III v4.step]
